DanielPerodin/Amplifier-Design-Tapeout-Summer-Fall-2026-/README.md

This repository contains:
1. The files that we were provided with at the start, in “Dr. Judy and Kenneth Materials”.
   
2. The models we developed, and circuit simulations I ran with them, in “Simulation_and_Modeling”.

3. The final GDS layout files of the designs that I made, in “MyDesigns”.
   
4. The final wafer that will be fabricated in EEE5354L, that was put together by Kenneth Fluker, in “Final_Wafer_By_Kenneth_Fluker”.
