DanielPerodin/Amplifier-Design-Tapeout-Summer-Fall-2026-/MyDesigns/DPerodin_Circuit_Labels.pptx

Current Source

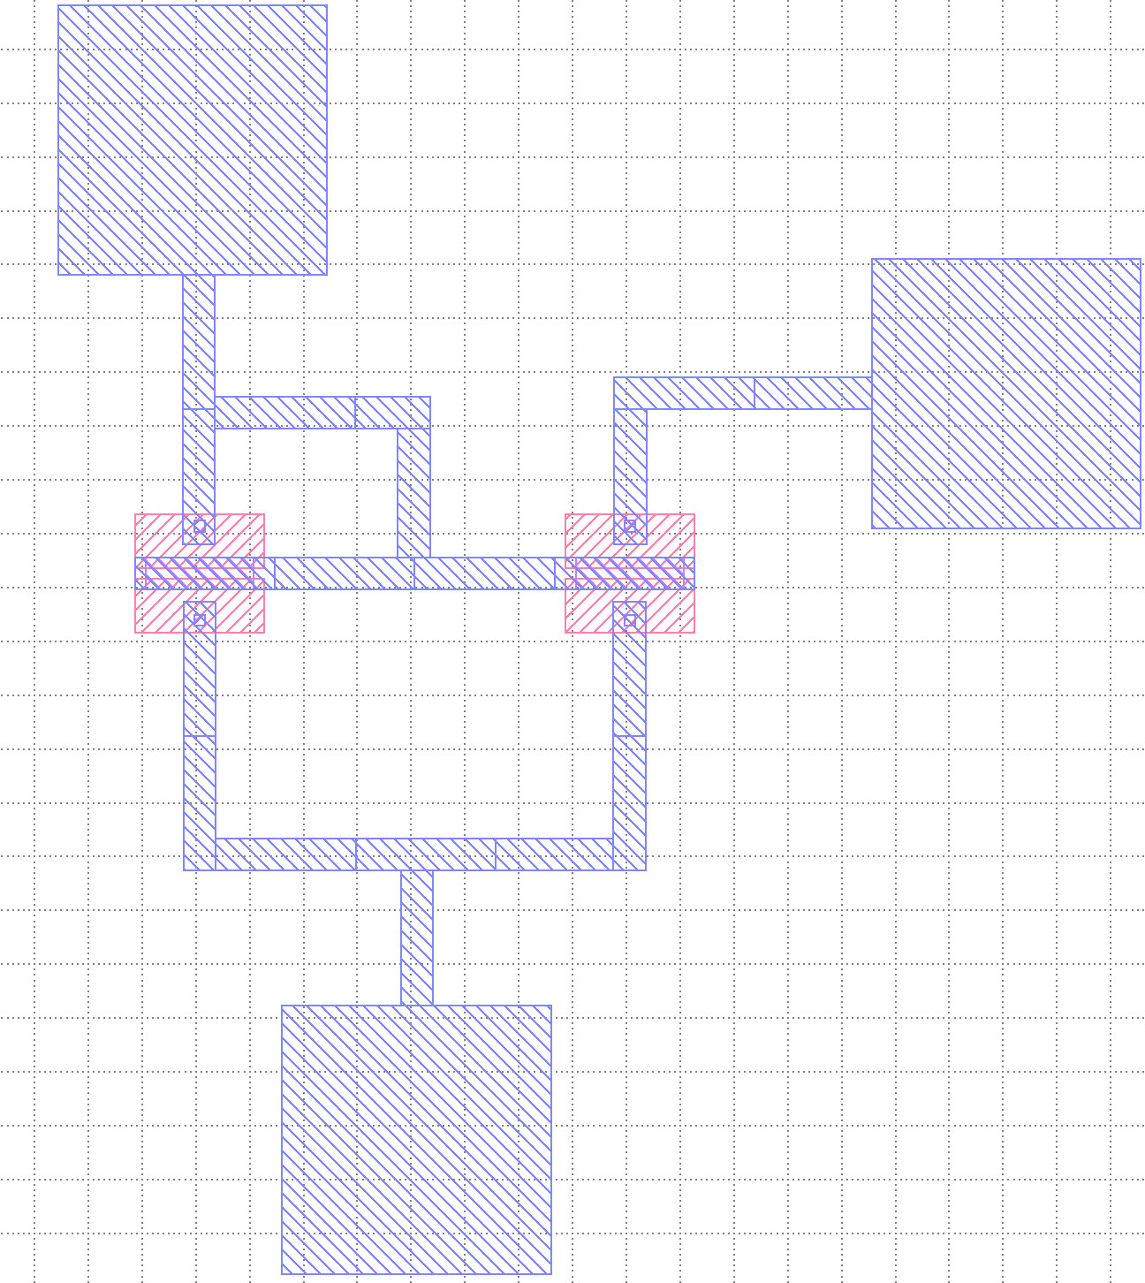
[picture p1: figure]

Rset

VCS

-V

## Slide 2

Common Source Amp

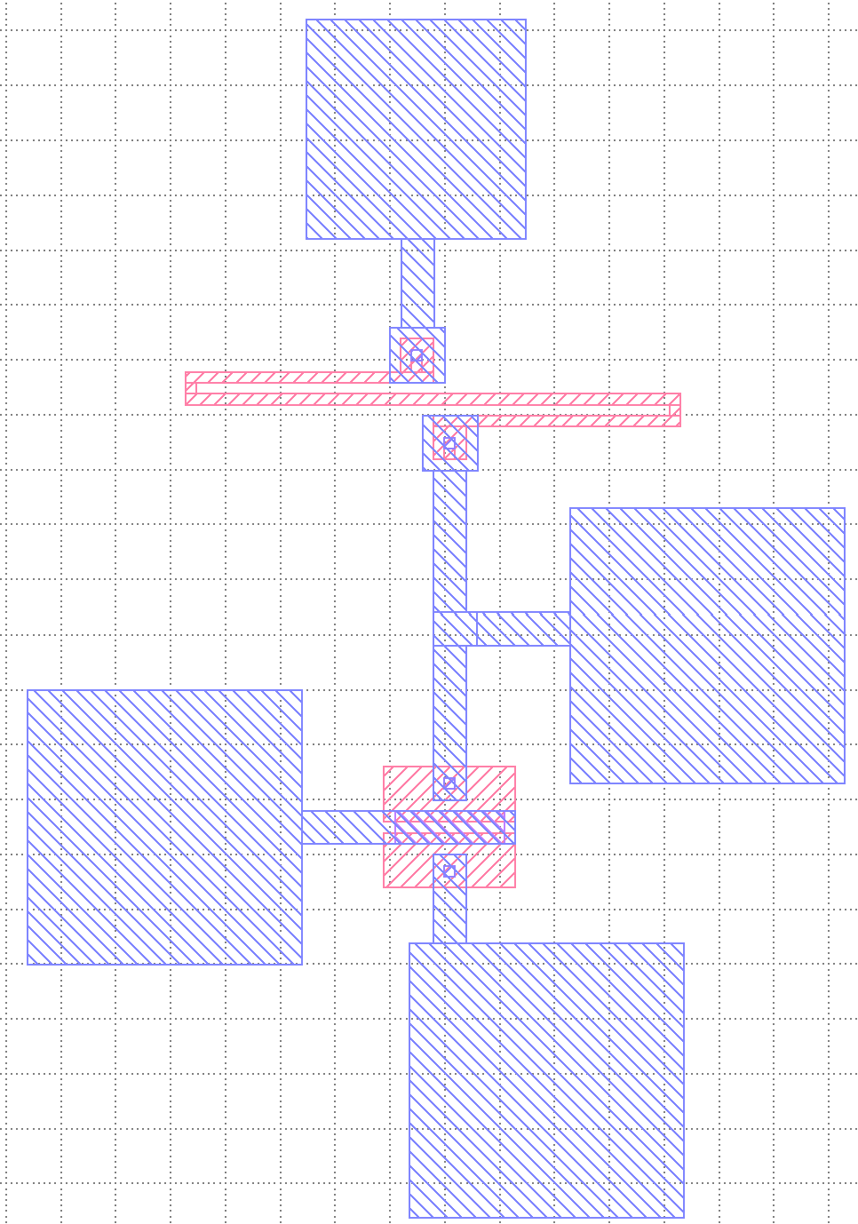
[picture p2: figure]

VDD

Vout

Vin

GND

## Slide 3

Differential Amp w/ Current

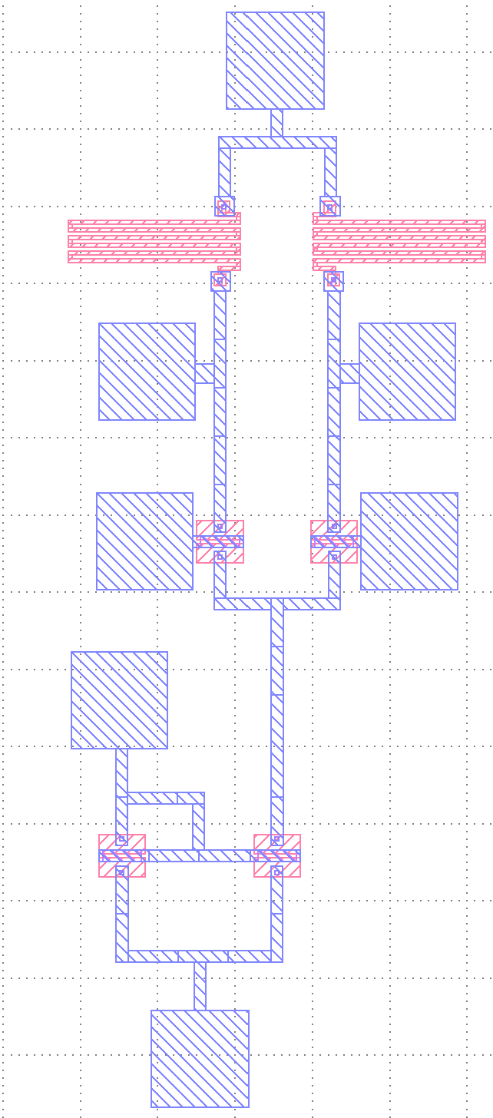
[picture p3: figure]

+V

Out1

Out2

Vin

GND

Rset

-V

## Slide 4

Differential Amp w/ Current

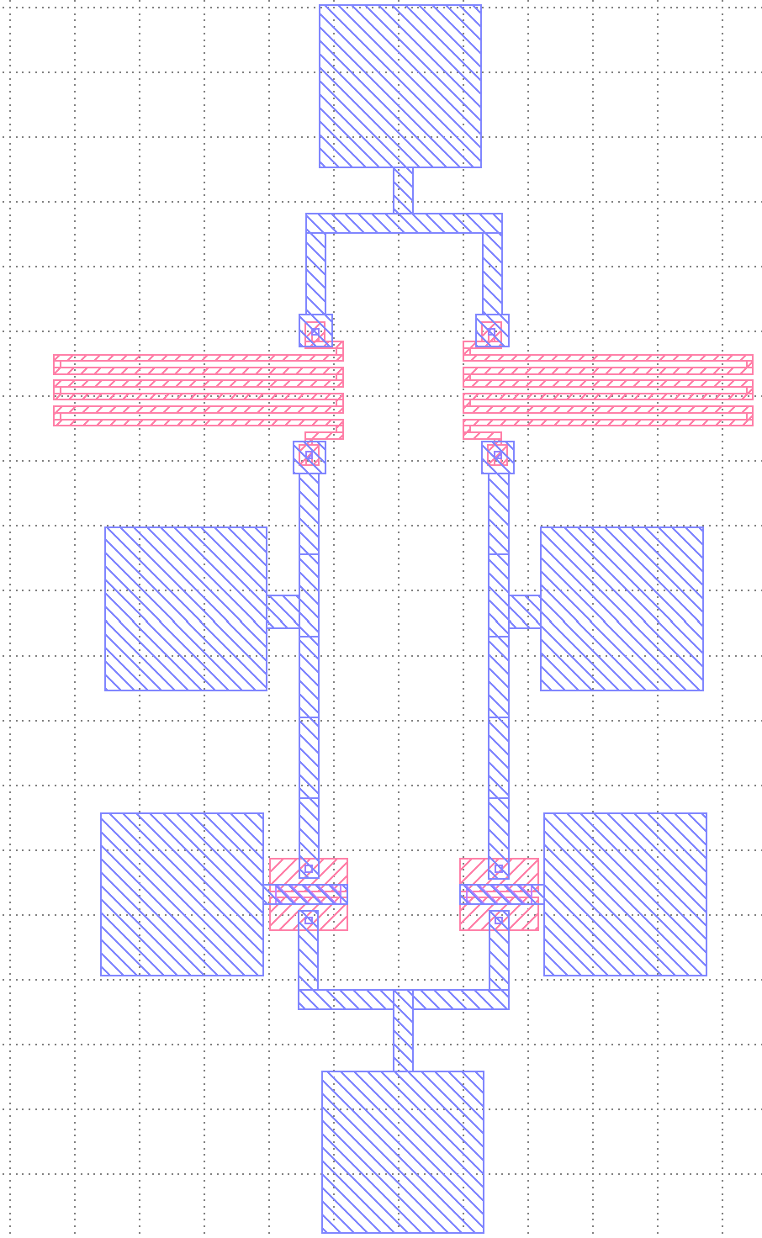
[picture p4: figure]

+V

Out1

Out2

Vin

GND

Current
