DanielPerodin/Amplifier-Design-Tapeout-Summer-Fall-2026-/Simulation_and_Modeling/10x100 SPICE Transistor Model_conf.pptx

## 10x100 Transistor Model

Daniel Perodin

## 10x100 Transistor

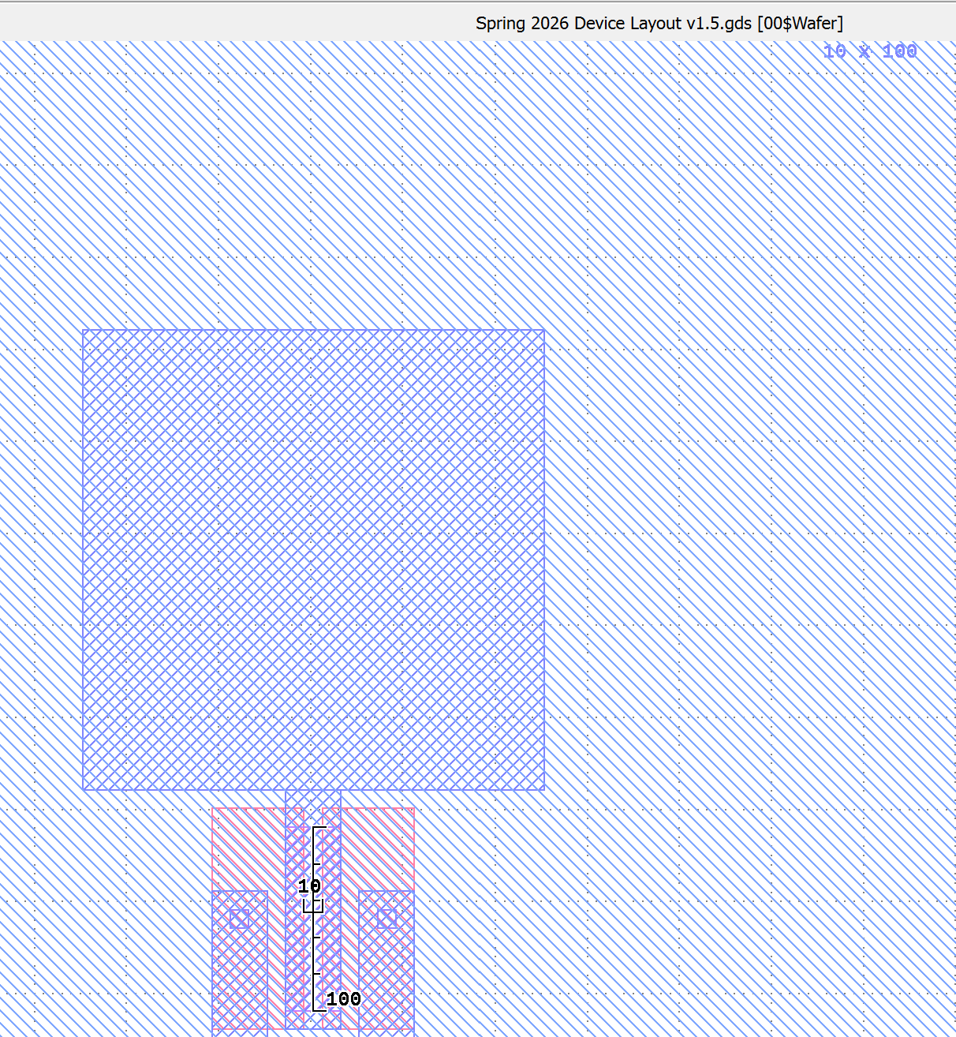
[picture p5: figure]
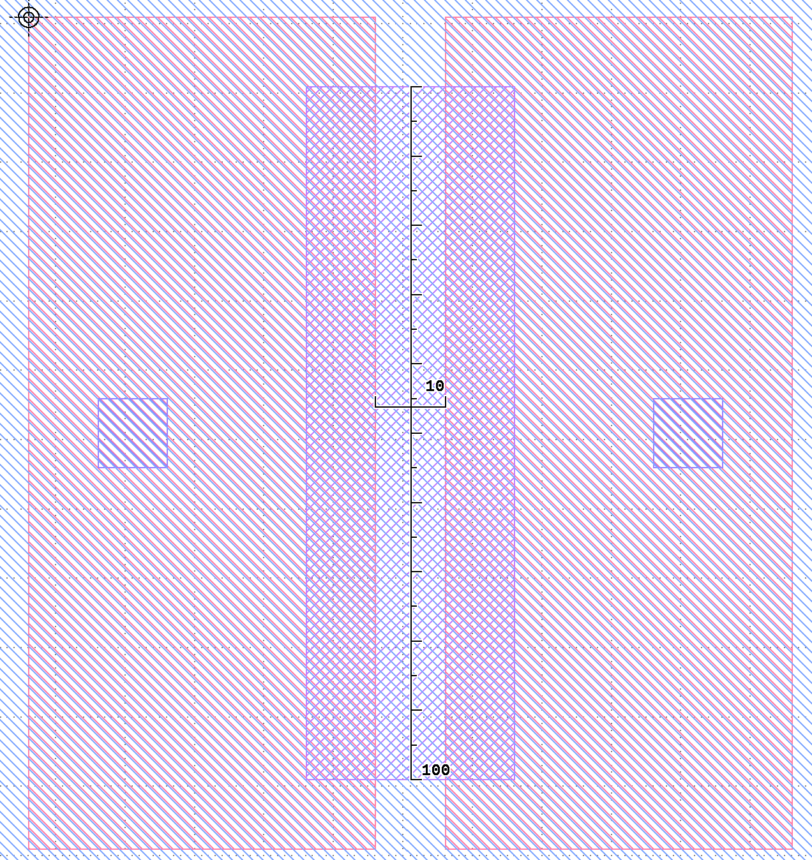
[picture p6: figure]

## Constructing the Model

.model SCRO_NMOS NMOS(
LEVEL= 1
TOX= 4e-8
PHI= 0.614
GAMMA= 0.31
VTO= 0.45 V
KP= 54.8u
LAMBDA= 0.0226
)

Parameter Calculation framework Credit: Nicolas Leeder

LAMBDA:
At VGS = 1.0V
ID(5V VDS)
≈ 2.026 mA
ID(10V VDS)
≈ 2.284 mA
λ ≈ 0.0226 V^-1

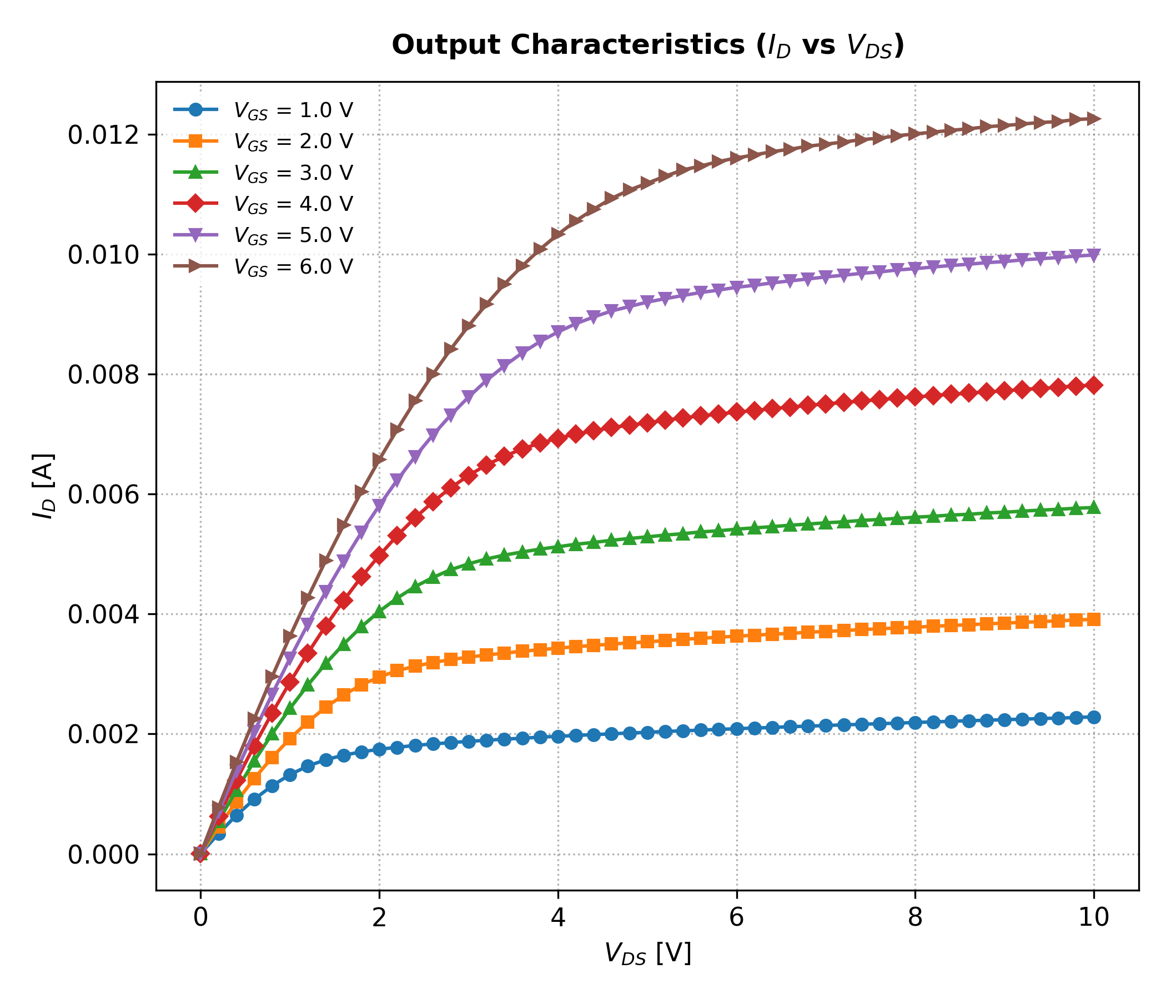
[picture p7: figure]
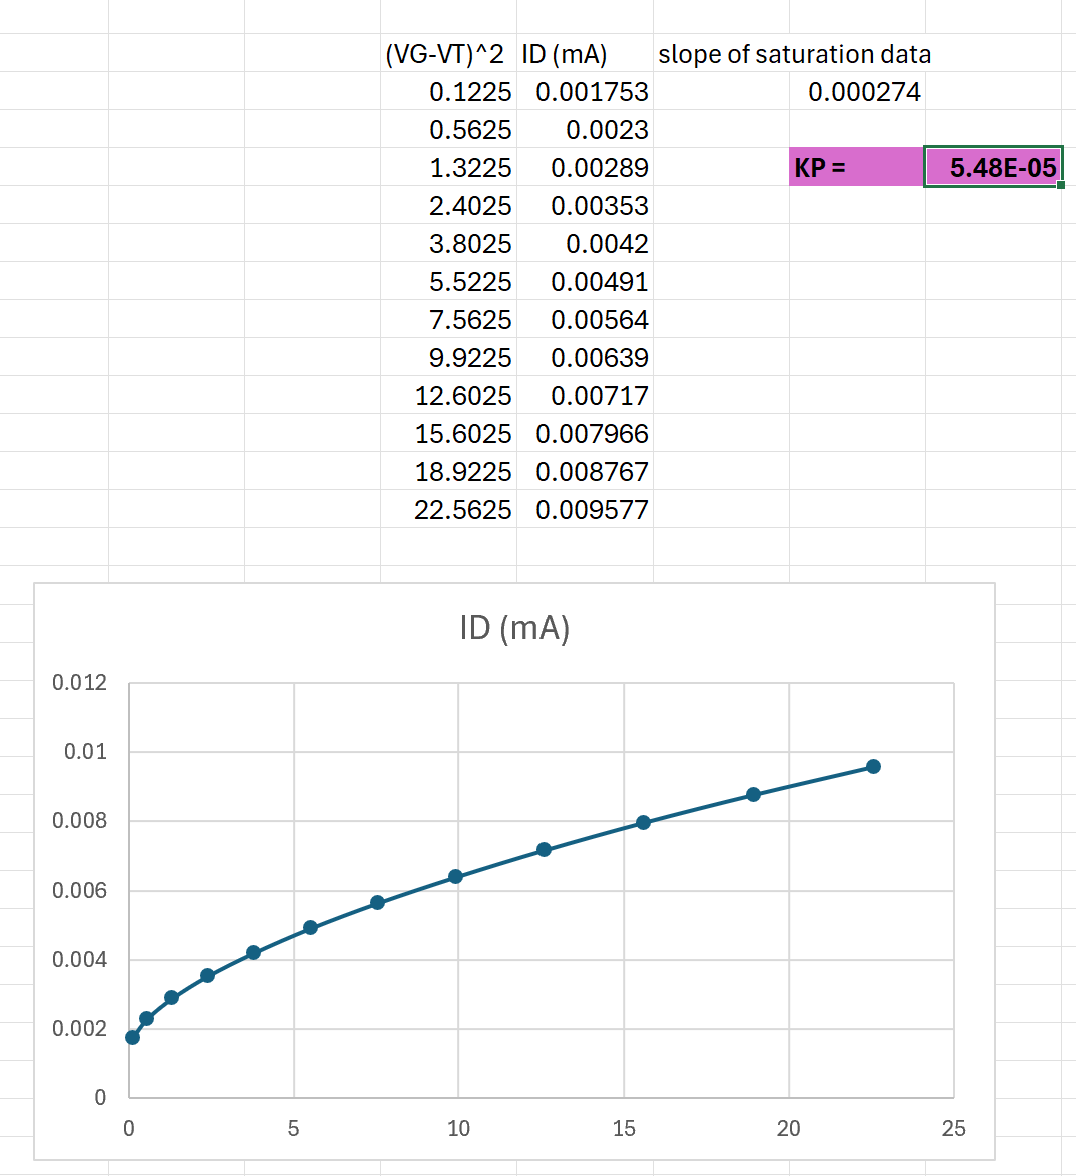
[picture p8: figure]
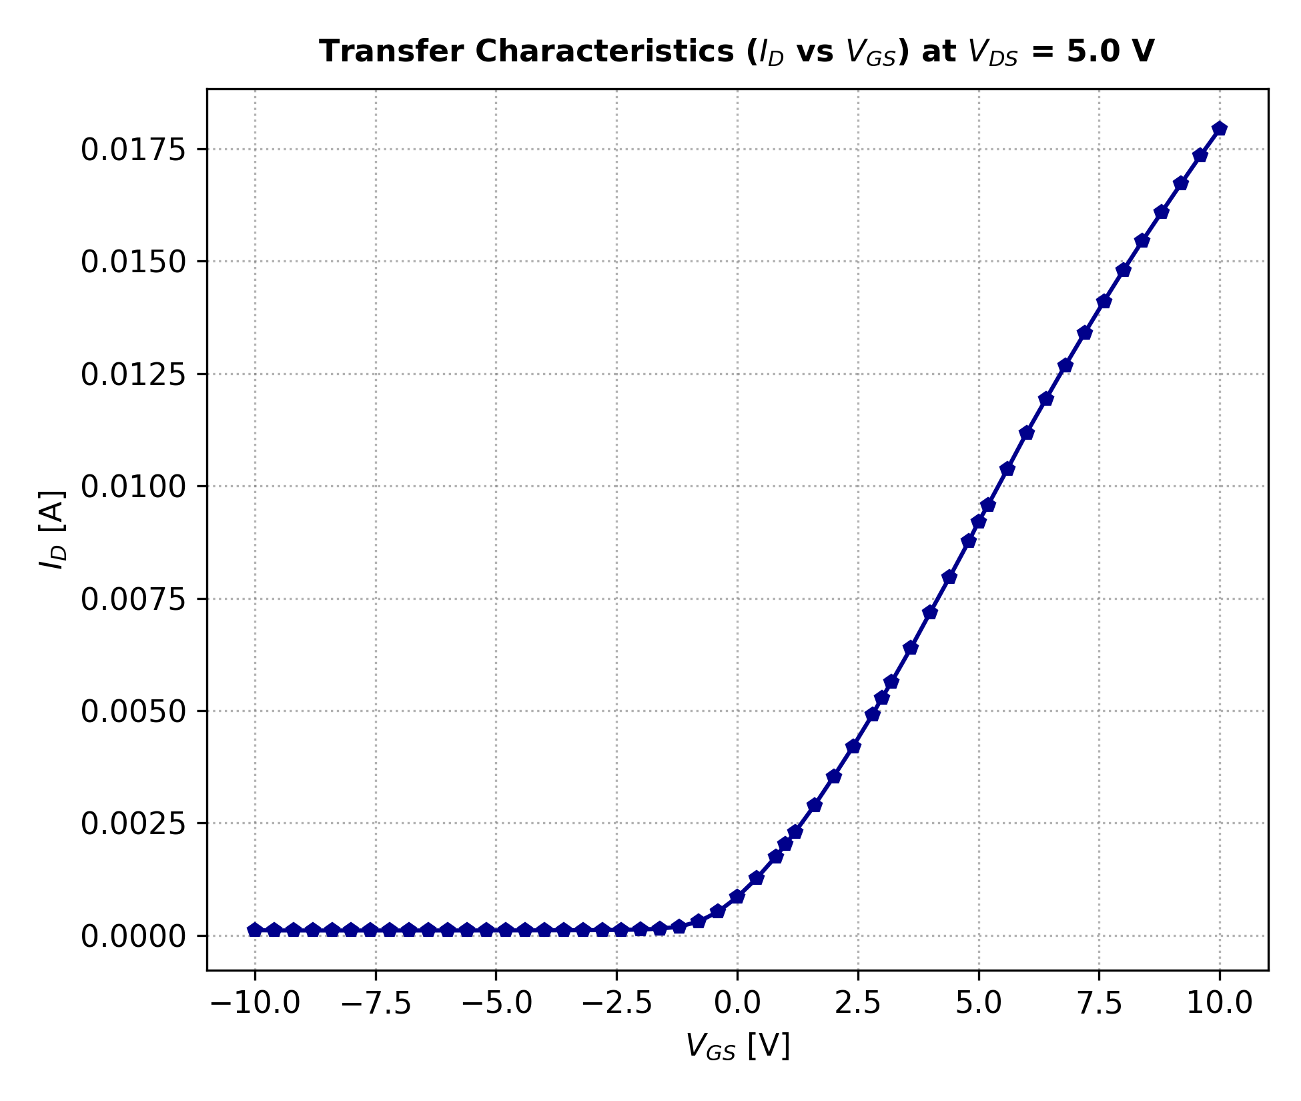
[picture p9: figure]

## Testing the model (Ltspice)

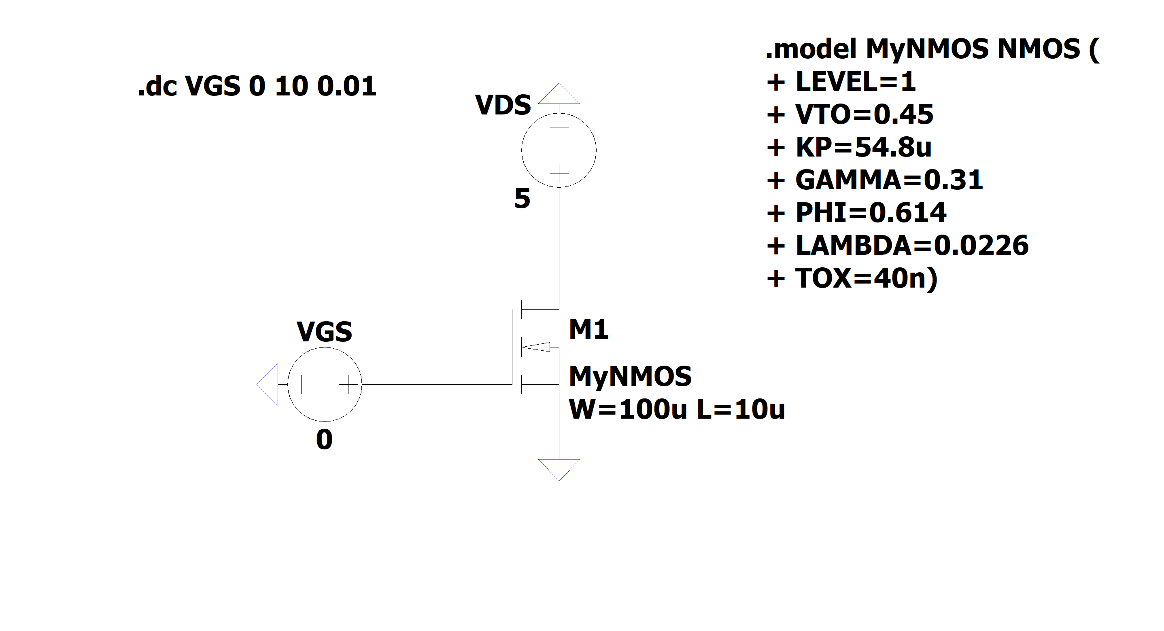
[picture p10: figure]

## Testing the model (LTspice)

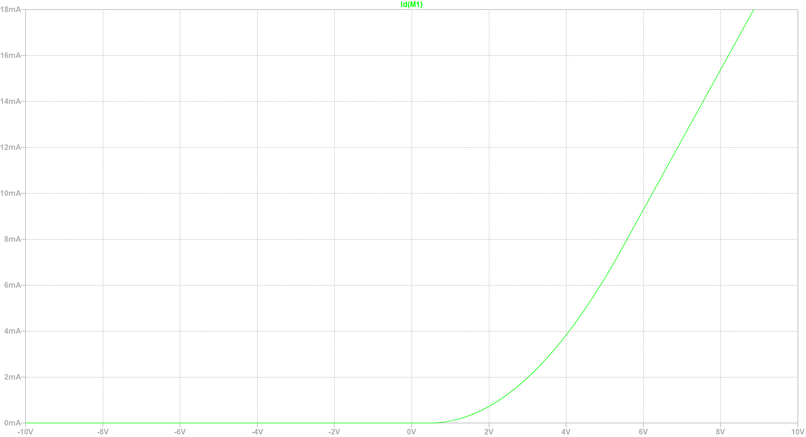
[picture p11: figure]

VGS

ID

## Slide 6

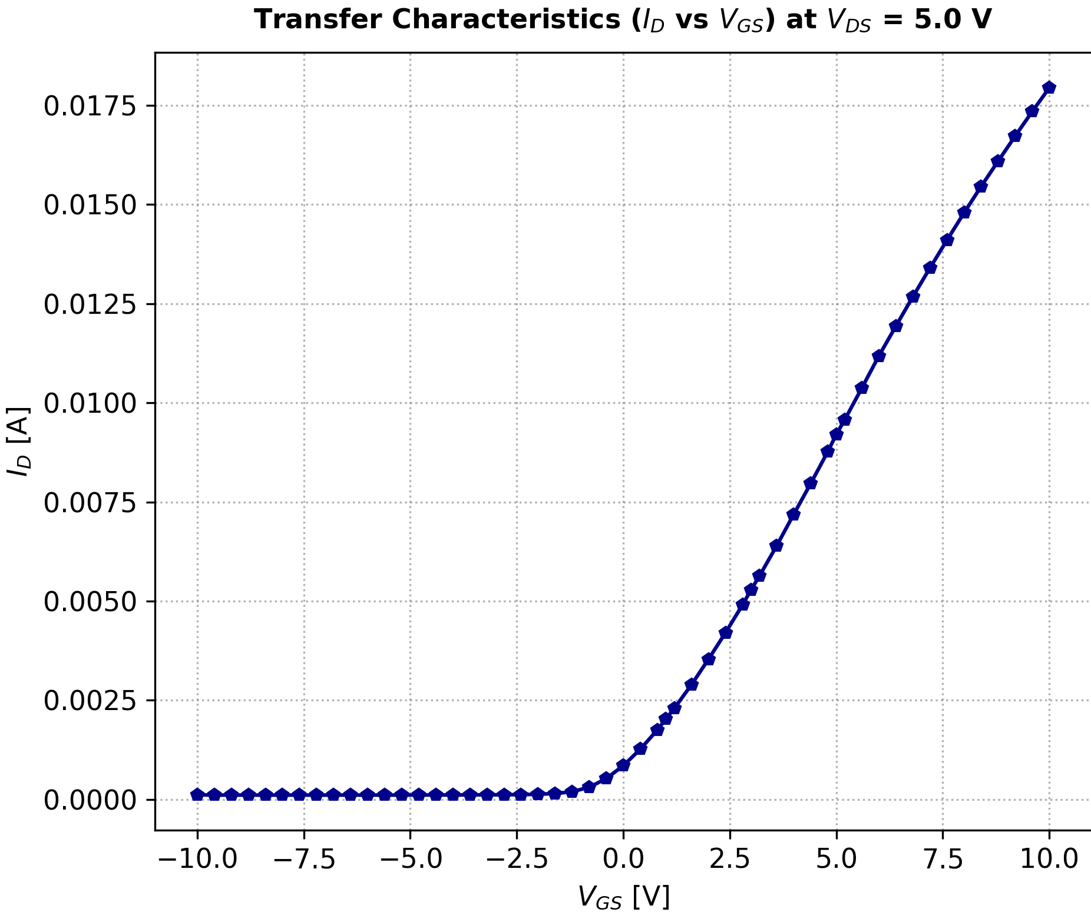
[picture p12: figure]
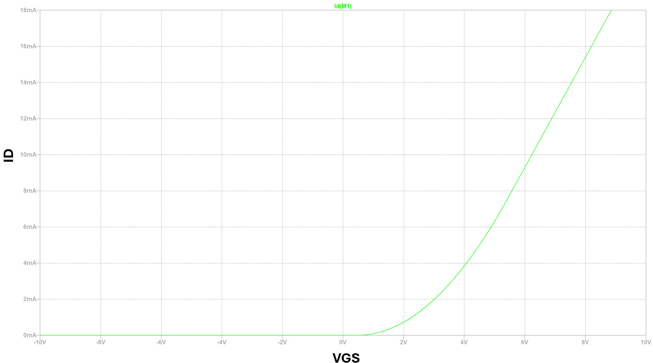
[picture p13: figure]

## Slide 7

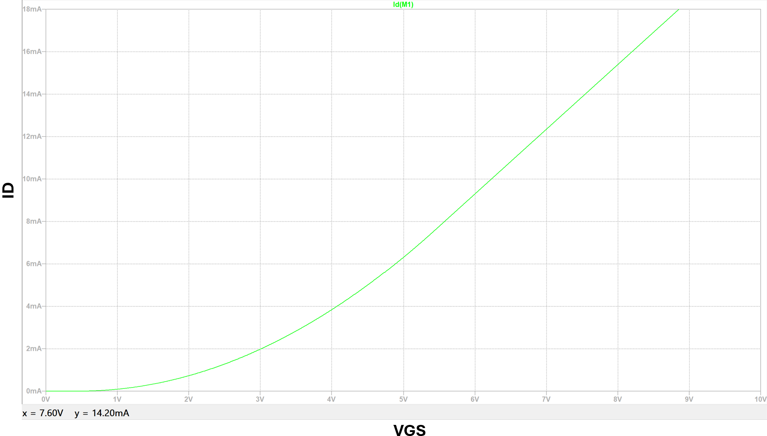
[picture p14: figure]

Looking at the recorded data from the fabricated transistors, the SPICE model is quite accurate for VGS between 7 V and 8 V, when VDS is kept at 5 V

## Slide 8

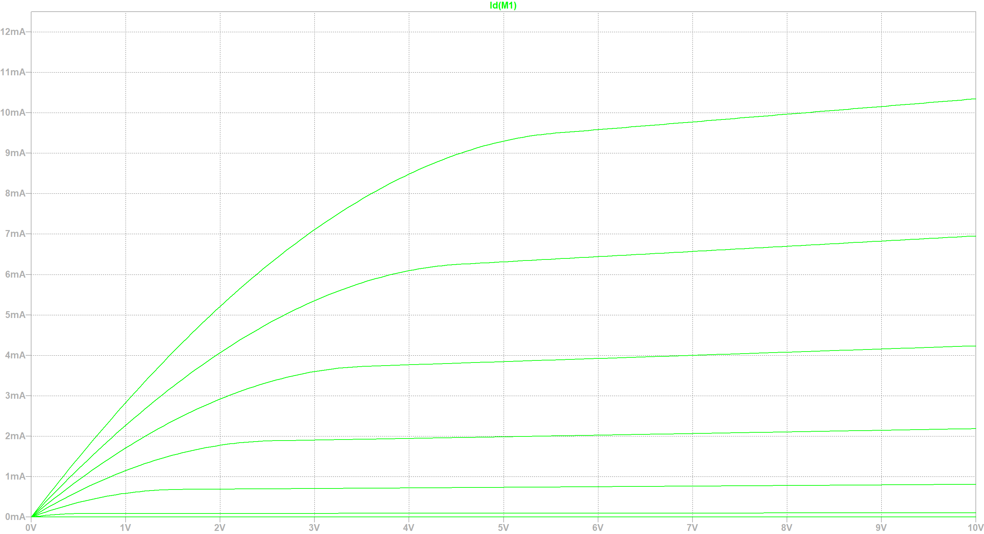
[picture p15: figure]

VGS = 6 V

VGS = 5 V

ID

VGS = 4 V

VGS = 3 V

VGS = 2 V

VGS = 1 V

VDS

## Slide 9

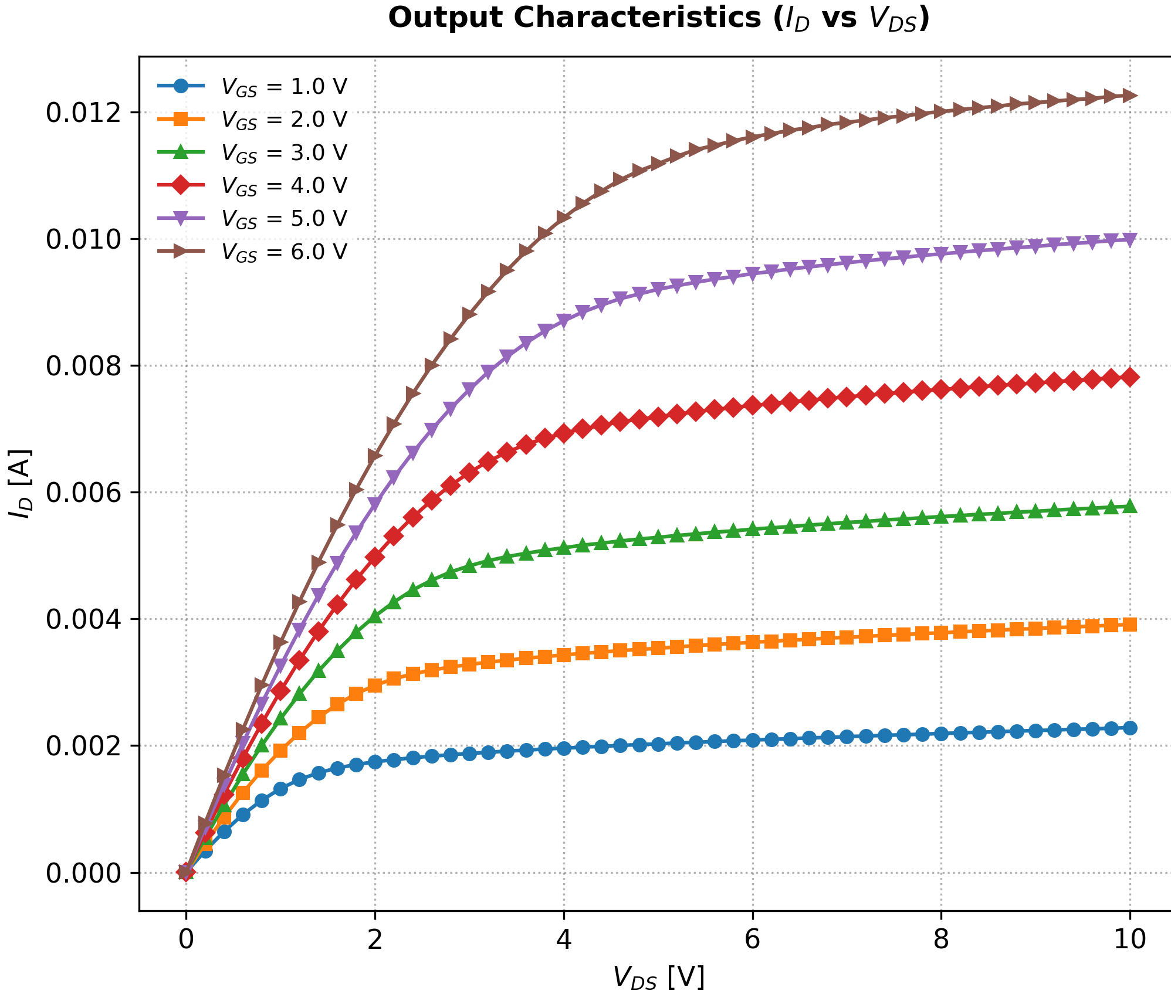
[picture p16: figure]
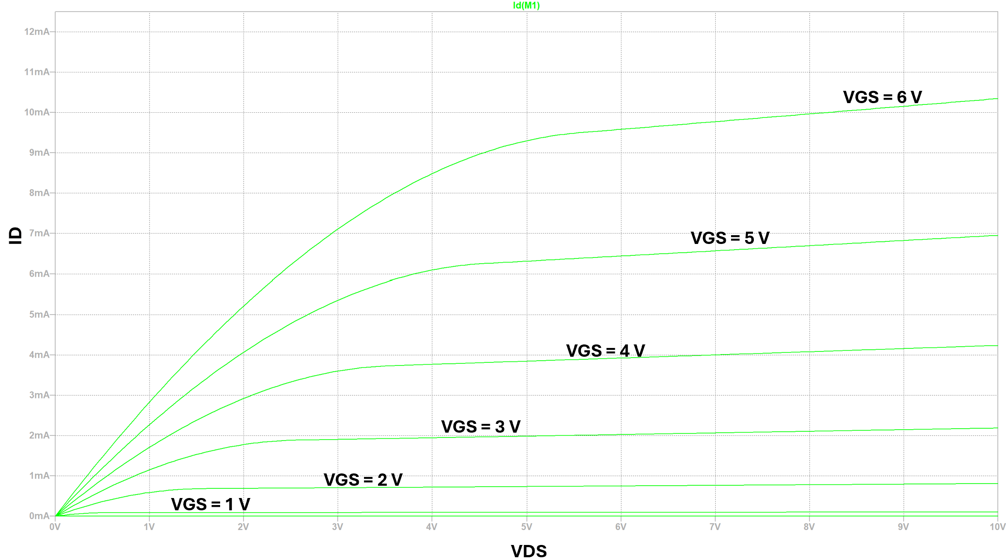
[picture p17: figure]

## Slide 10

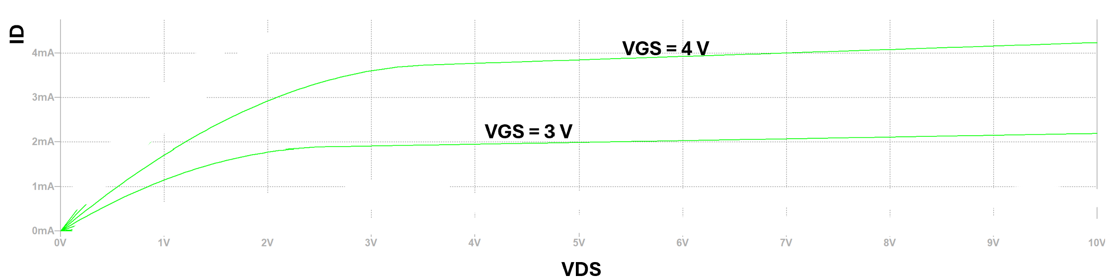
[picture p18: figure]
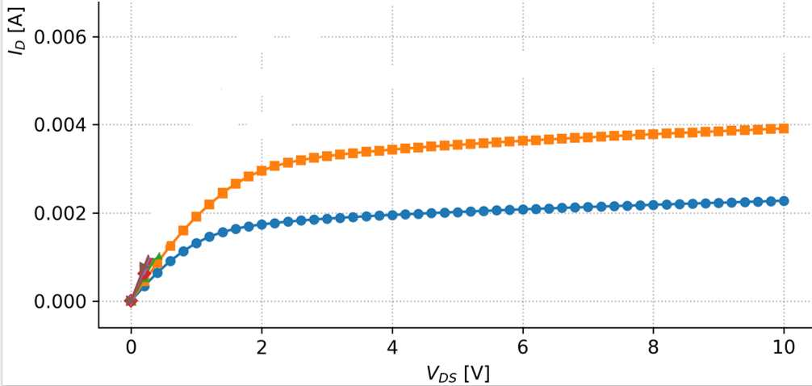
[picture p19: figure]

## Slide 11

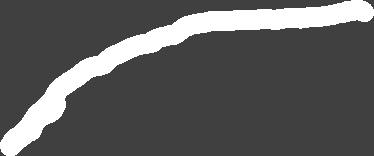
[picture p20: figure]
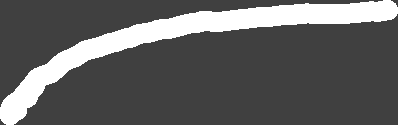
[picture p21: figure]
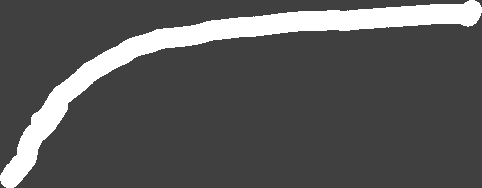
[picture p22: figure]
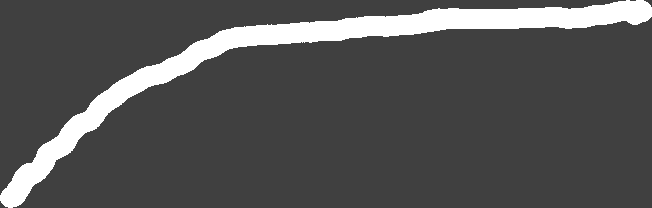
[picture p23: figure]
