DanielPerodin/Amplifier-Design-Tapeout-Summer-Fall-2026-/Simulation_and_Modeling/10x10/10x10_ransfer_curve_Vds_10.0_V.png

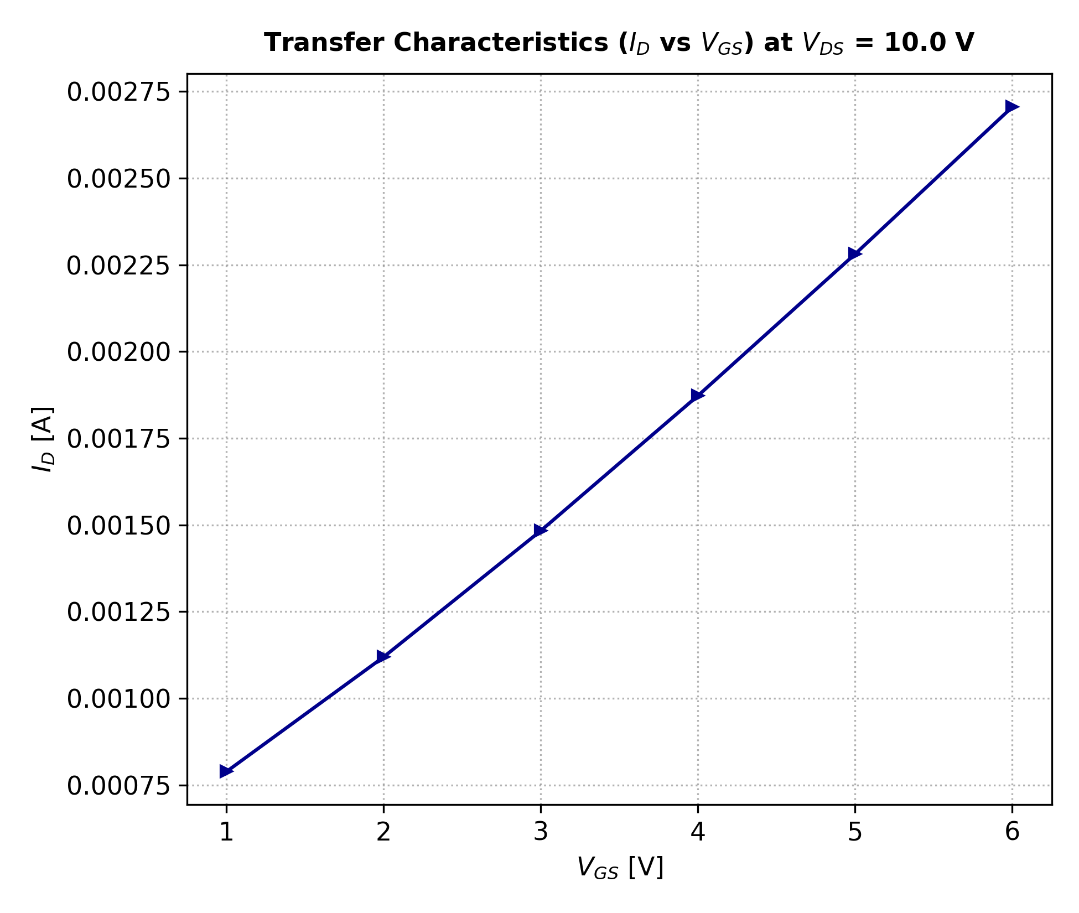
Simulation_and_Modeling/10x10/10x10_ransfer_curve_Vds_10.0_V.png
