DanielPerodin/Amplifier-Design-Tapeout-Summer-Fall-2026-/Simulation_and_Modeling/10x100/transfer_curve_Vds_3.4_V.png

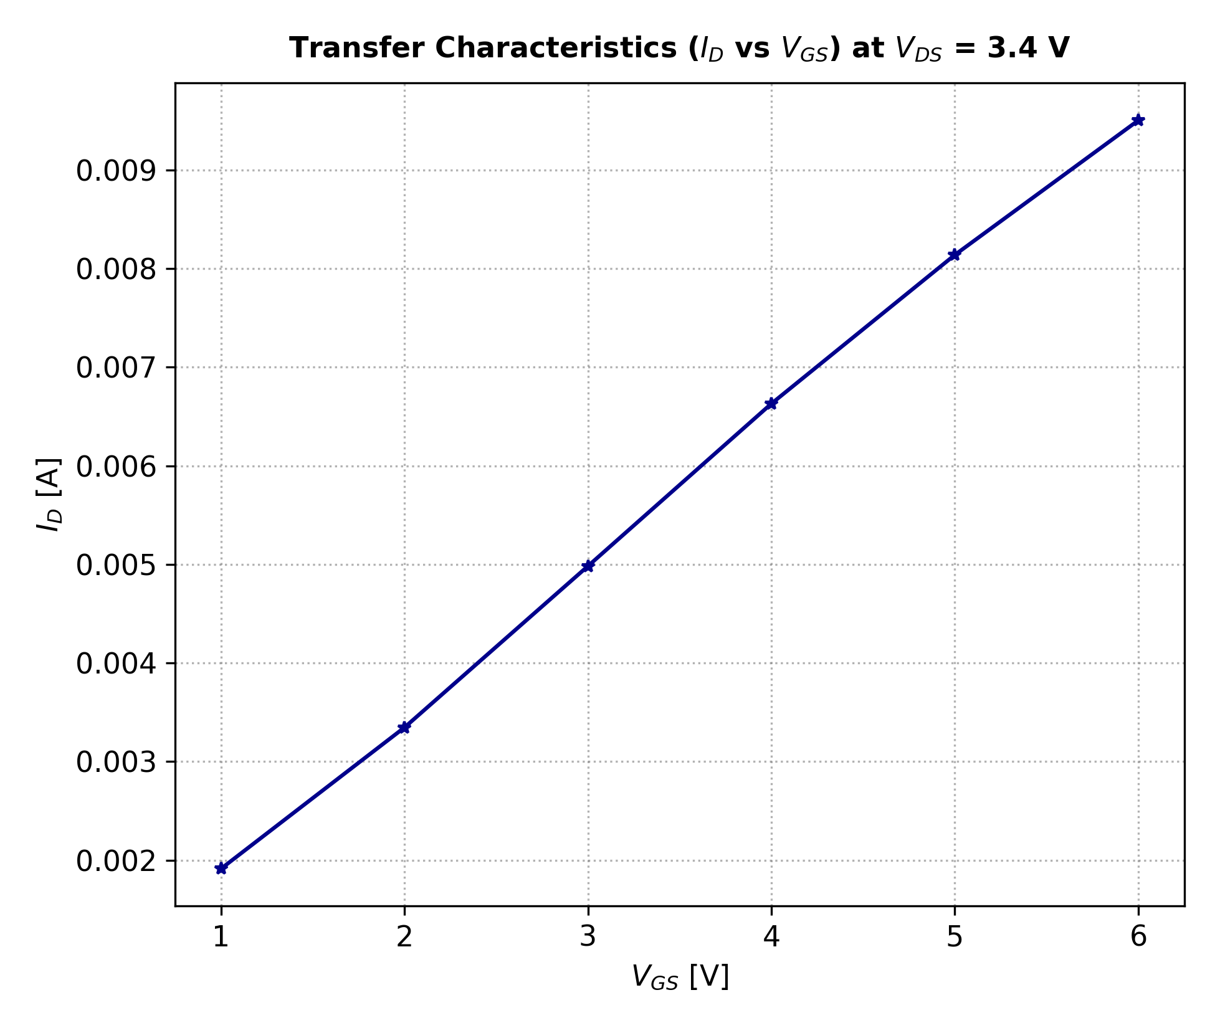
Simulation_and_Modeling/10x100/transfer_curve_Vds_3.4_V.png
