DanielPerodin/Amplifier-Design-Tapeout-Summer-Fall-2026-/Simulation_and_Modeling/10x100/transfer_curve_Vds_6.2_V.png

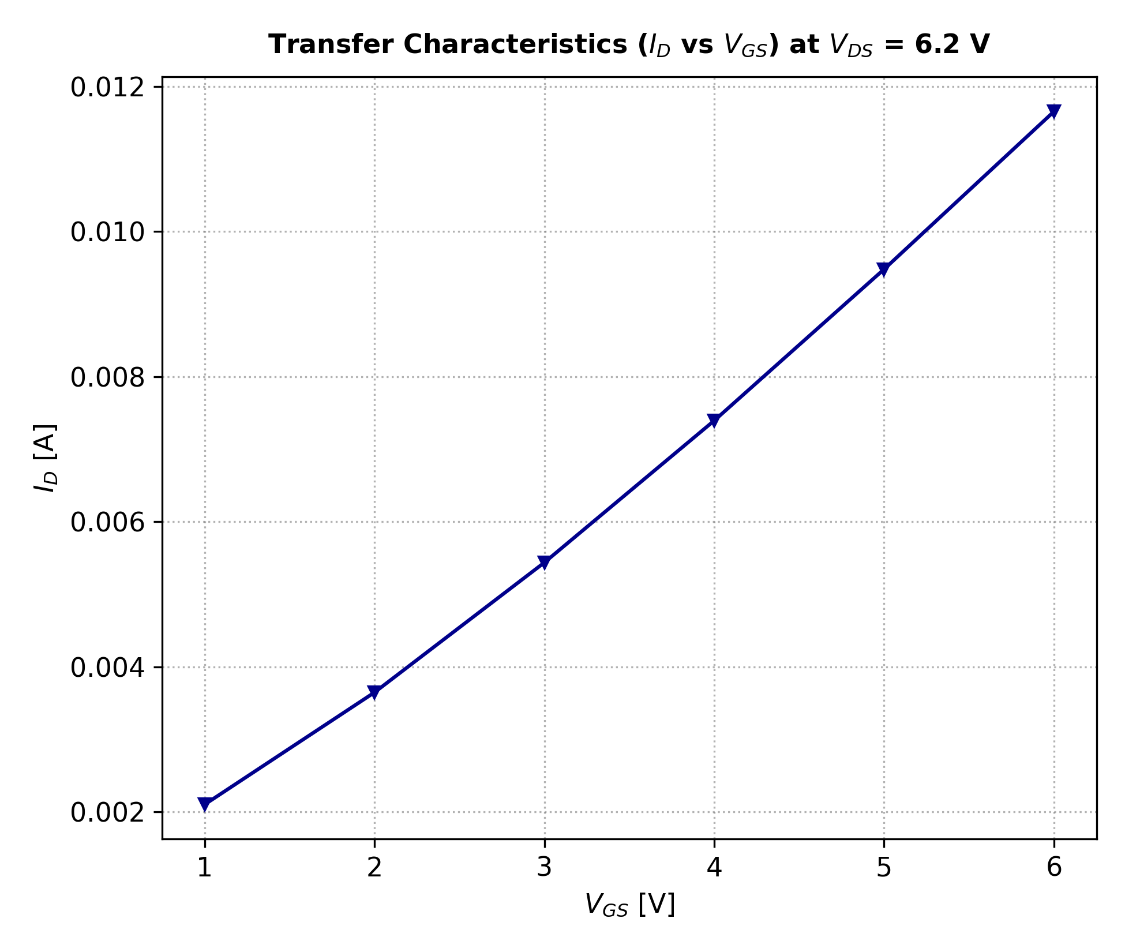
Simulation_and_Modeling/10x100/transfer_curve_Vds_6.2_V.png
