DanielPerodin/Amplifier-Design-Tapeout-Summer-Fall-2026-/Dr. Judy and Kenneth Materials/Cross Sections - KF v2.pptx

## Transistor Cross Sections

Kenneth Fluker

## Silicon Wafer

## Thermal Oxidation (Wet)

## Mask 1: Active Areas

## BOE Etch

## Resist Strip

## Spin-on-Glass

## Thermal Diffusion

## Mask 2: Gate Oxide

## BOE Etch

## Resist Strip

## Thermal Oxidation (Dry)

## Mask 3: Contact Areas

## BOE Etch

## Resist Strip

## Mask 4: Metal

## Sputtering

## Liftoff
