DanielPerodin/Amplifier-Design-Tapeout-Summer-Fall-2026-/Simulation_and_Modeling/10x10/output_characteristics_Id_vs_Vds.png

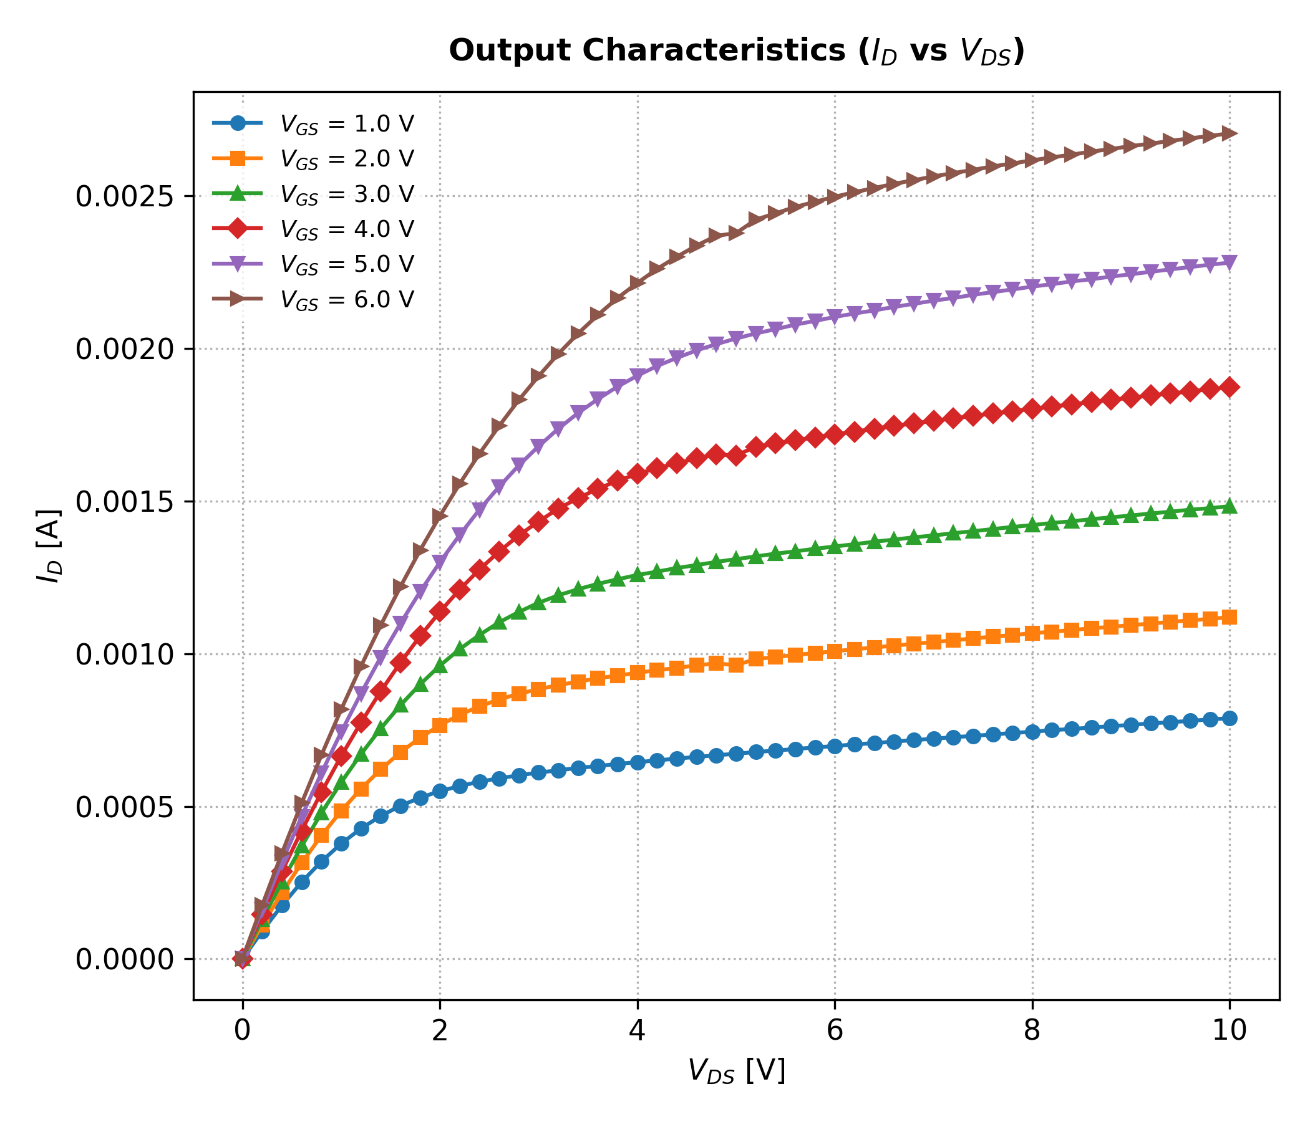
Simulation_and_Modeling/10x10/output_characteristics_Id_vs_Vds.png
