DanielPerodin/Amplifier-Design-Tapeout-Summer-Fall-2026-/Simulation_and_Modeling/CS_Amp.asc

M1: nmos; MyNMOS; W=100u L=10u
RD: res; 1658.8
VDD: voltage; 10
VG: voltage; 4
Vin: voltage; SINE(0 100m 1k)
Named nets: 0, out, in
.model MyNMOS NMOS (
+ LEVEL=1
+ VTO=0.45
+ KP=54.8u
+ GAMMA=0.31
+ PHI=0.614
+ LAMBDA=0.0226
+ TOX=40n)
.tran 10m
