DanielPerodin/Amplifier-Design-Tapeout-Summer-Fall-2026-/Simulation_and_Modeling/Current_Source.asc

M1: nmos; MyNMOS; W=100u L=10u
M2: nmos; MyNMOS; W=100u L=10u
Rset: res; 1.85k
V1: voltage; -10
VCS: voltage; -3
VDD: voltage; 1
Named nets: 0, VGS
.model MyNMOS NMOS (
+ LEVEL=1
+ VTO=0.45
+ KP=54.8u
+ GAMMA=0.31
+ PHI=0.614
+ LAMBDA=0.0226
+ TOX=40n)
.op
