DanielPerodin/Amplifier-Design-Tapeout-Summer-Fall-2026-/Simulation_and_Modeling/Diff_Amp_V1.asc

+V: voltage; 9
-V: voltage; -9
M1: nmos; MyNMOS; W=100u L=10u
M2: nmos; MyNMOS; W=100u L=10u
M3: nmos; MyNMOS; W=100u L=10u
M4: nmos; MyNMOS; W=100u L=10u
RD1: res; 5.238k
RD2: res; 5.238k
Rset1: res; 1.85k
V3: voltage; SINE(0 100m 1k)
VDD1: voltage; 1
Named nets: 0, VG, Out2, Out1, In, VS, VCS
.op
.model MyNMOS NMOS (
+ LEVEL=1
+ VTO=0.45
+ KP=54.8u
+ GAMMA=0.31
+ PHI=0.614
+ LAMBDA=0.0226
+ TOX=40n)
.tran 0 10m 0
